xerootg/esp32_zune_bluetooth/pdf/esp32-zune-bluetoothaudio.pdf

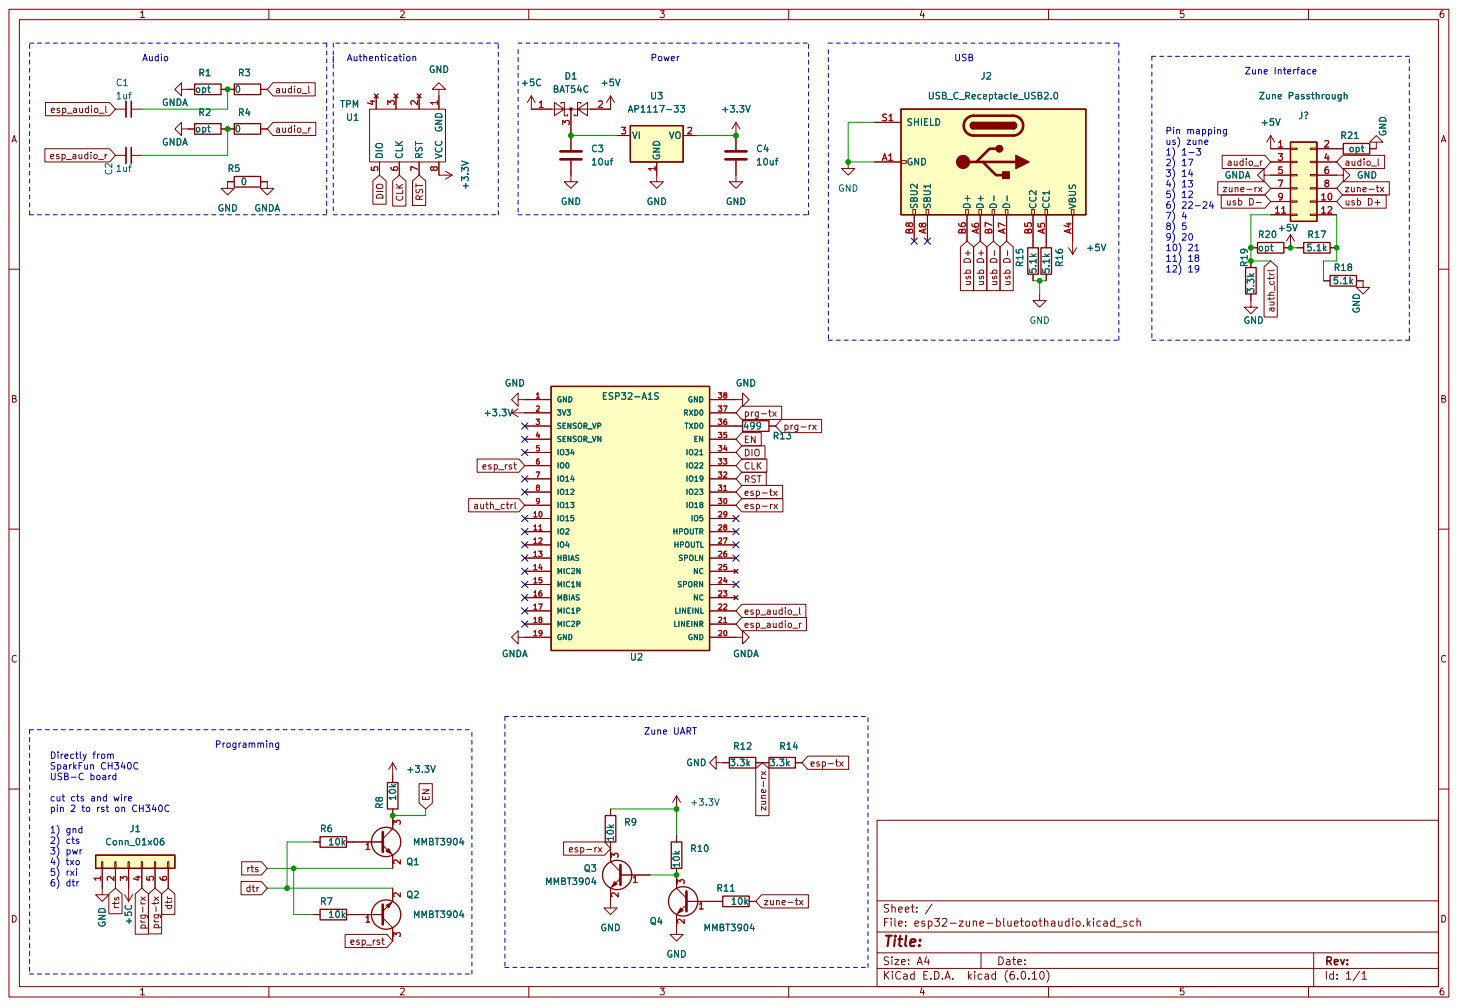
[picture p1: page 1]

1 VO 2 VI 3 GND GND GND

cut cts and wire pin 2 to rst on CH340C

File: esp32-zune-bluetoothaudio.kicad_sch Sheet: /
Id: 1/1 Title:
