xerootg/esp32_zune_bluetooth/esp32-zune-bluetoothaudio.kicad_pcb

## KiCad design esp32-zune-bluetoothaudio.kicad_pcb (2023-01-27)

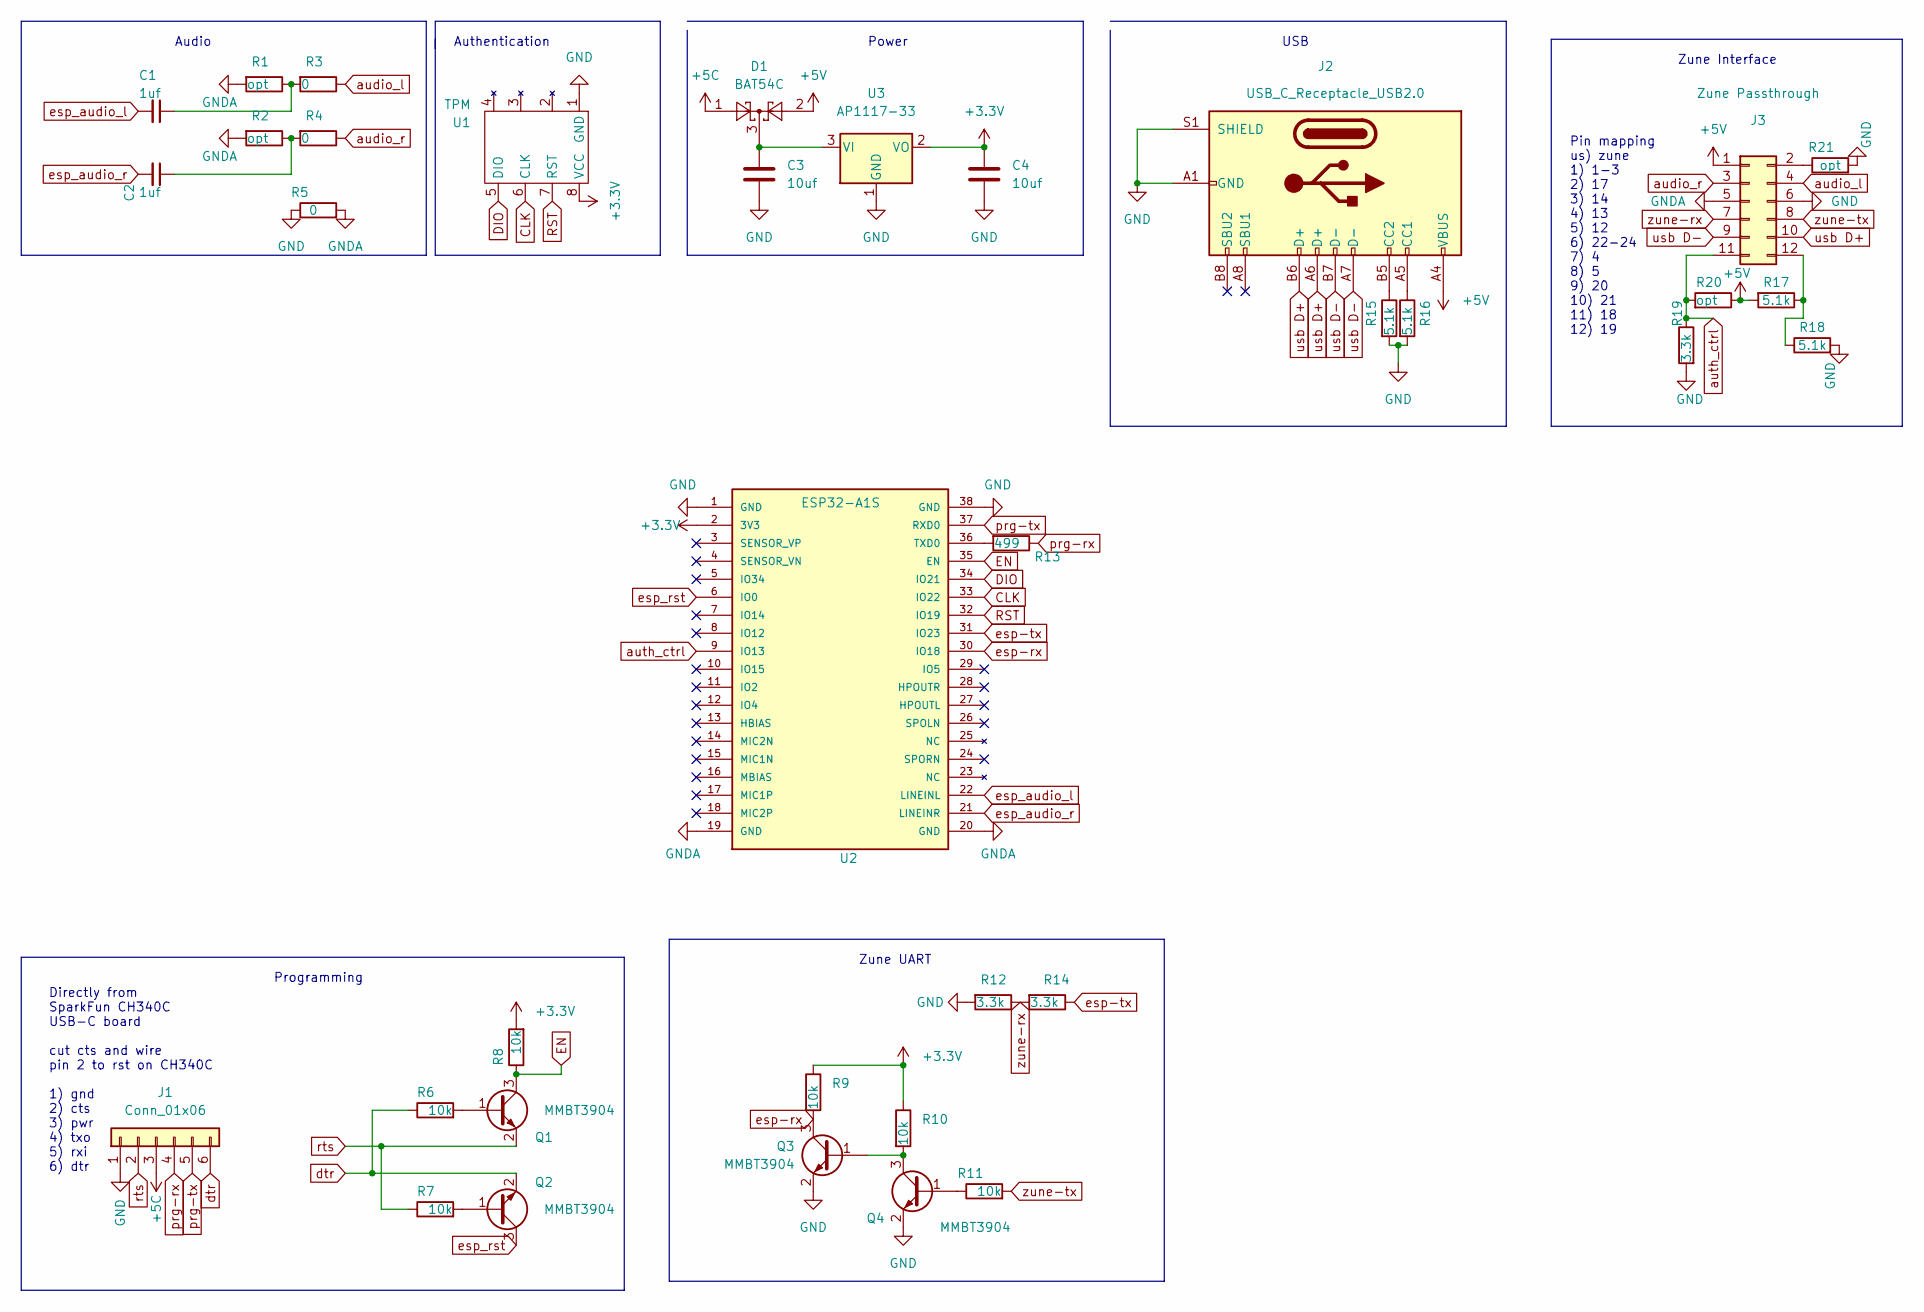
[picture p2: schematic esp32-zune-bluetoothaudio.kicad_sch]

Parts:
C1, C2: 1uf; C_0805_2012Metric_Pad1.18x1.45mm_HandSolder
C3, C4: 10uf; C_0805_2012Metric_Pad1.18x1.45mm_HandSolder
D1: BAT54C; SOT-23
J1: Conn_01x06; PinHeader_1x06_P2.54mm_Vertical
J2: USB_C_Receptacle_USB2.0; USB_C_Receptacle_XKB_U262-16XN-4BVC11
J3: Zune Passthrough; PinHeader_2x06_P2.00mm_Vertical_SMD
Q1, Q2, Q3, Q4: MMBT3904; SOT-23
R1, R2, R20, R21: opt; R_0805_2012Metric_Pad1.20x1.40mm_HandSolder
R3, R4, R5: 0; R_0805_2012Metric_Pad1.20x1.40mm_HandSolder
R6, R7, R8, R9, R10, R11: 10k; R_0805_2012Metric_Pad1.20x1.40mm_HandSolder
R12, R14, R19: 3.3k; R_0805_2012Metric_Pad1.20x1.40mm_HandSolder
R13: 499; R_0805_2012Metric_Pad1.20x1.40mm_HandSolder
R15, R16, R17, R18: 5.1k; R_0805_2012Metric_Pad1.20x1.40mm_HandSolder
U1: TPM; Infineon_PG-DSO-8-27_3.9x4.9mm_EP2.65x3mm
U2: ESP32-A1S; PARTREV 4
U3: AP1117-33; SOT-223-3_TabPin2

Connections:
+3.3V: C4.1, R8.2, R9.1, R10.1, U1.8 (VCC), U2.2 (3V3), U3.2 (VO)
+5C: D1.1, J1.3
+5V: D1.2, J2.A4 (VBUS), J2.A9 (VBUS), J2.B4 (VBUS), J2.B9 (VBUS), J3.1, R17.2, R20.1
CLK: U1.6 (CLK), U2.33 (IO22)
DIO: U1.5 (DIO), U2.34 (IO21)
EN: Q1.3 (C), R8.1, U2.35 (EN)
GND: C3.2, C4.2, J1.1, J2.A1 (GND), J2.A12 (GND), J2.B1 (GND), J2.B12 (GND), J2.S1 (SHIELD), J3.6, Q3.2 (E), Q4.2 (E), R5.1, R12.2, R15.2, R16.2, R18.2, R19.2, R21.2, U1.1 (GND), U2.1 (GND), U2.38 (GND), U3.1 (GND)
GNDA: J3.5, R1.2, R2.2, R5.2, U2.19 (GND), U2.20 (GND)
unnamed: C1.1, R1.1, R3.2
unnamed: C2.1, R2.1, R4.2
unnamed: C3.1, D1.3, U3.3 (VI)
unnamed: J2.A5 (CC1), R16.1
unnamed: J2.B5 (CC2), R15.1
unnamed: Q1.1 (B), R6.2
unnamed: Q2.1 (B), R7.2
unnamed: Q3.1 (B), Q4.3 (C), R10.2
unnamed: Q4.1 (B), R11.1
unnamed: R13.2, U2.36 (TXD0)
unnamed: J3.12, R17.1, R18.1
unnamed: J3.2, R21.1
RST: U1.7 (RST), U2.32 (IO19)
audio_l: J3.4, R3.1
audio_r: J3.3, R4.1
auth_ctrl: J3.11, R19.1, R20.2, U2.9 (IO13)
dtr: J1.6, Q2.2 (E), R6.1
esp-rx: Q3.3 (C), R9.2, U2.30 (IO18)
esp-tx: R14.1, U2.31 (IO23)
esp_audio_l: C1.2, U2.22 (LINEINL)
esp_audio_r: C2.2, U2.21 (LINEINR)
esp_rst: Q2.3 (C), U2.6 (IO0)
prg-rx: J1.4, R13.1
prg-tx: J1.5, U2.37 (RXD0)
rts: J1.2, Q1.2 (E), R7.1
usb D+: J2.A6 (D+), J2.B6 (D+), J3.10
usb D-: J2.A7 (D-), J2.B7 (D-), J3.9
zune-rx: J3.7, R12.1, R14.2
zune-tx: J3.8, R11.2

Notes on the sheet:
Zune Interface
Pin mapping us) zune 1) 1-3 2) 17 3) 14 4) 13 5) 12 6) 22-24 7) 4 8) 5 9) 20 10) 21 11) 18 12) 19
Zune UART
Authentication
USB
Audio
Programming
Power
Directly from SparkFun CH340C USB-C board cut cts and wire pin 2 to rst on CH340C 1) gnd 2) cts 3) pwr 4) txo 5) rxi 6) dtr

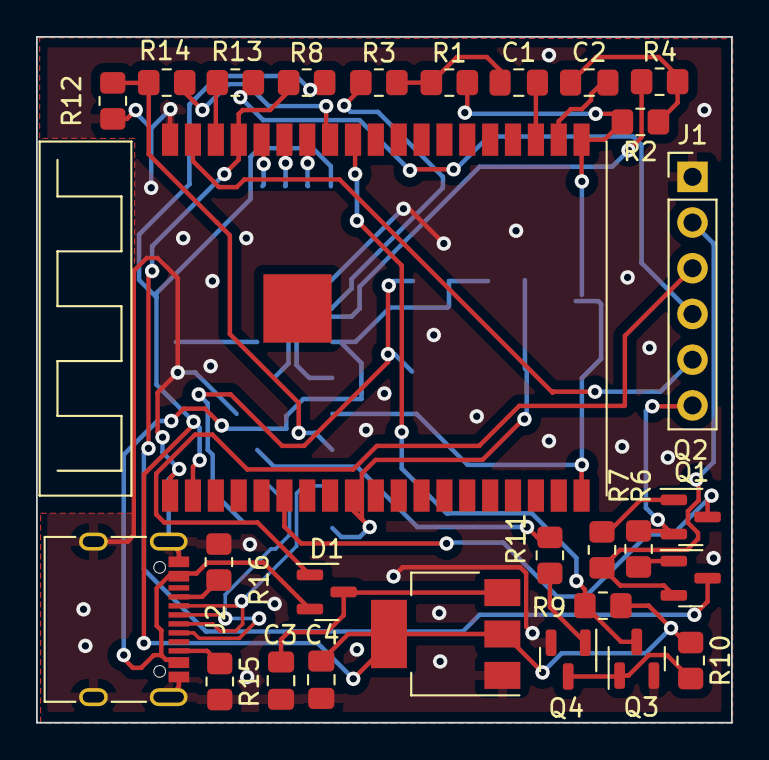
[picture p3: board esp32-zune-bluetoothaudio.kicad_pcb from above]

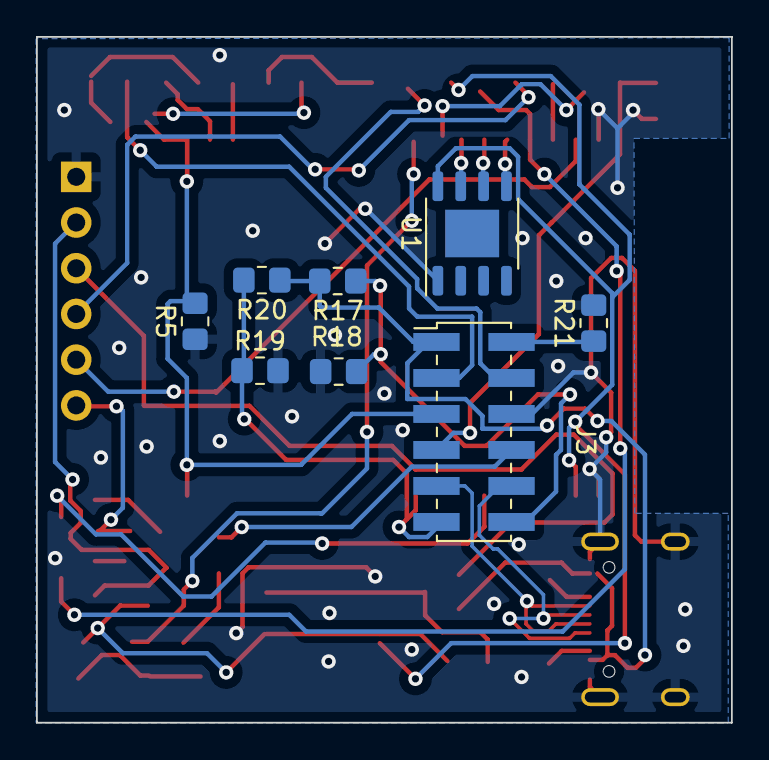
[picture p4: board esp32-zune-bluetoothaudio.kicad_pcb from below]

Board: 2 copper layers, 38.6 x 38.1 mm, 36 parts (8 on the bottom side), 37 nets.
