xerootg/esp32_zune_bluetooth/(commit log)

2023-01-10 Got a start atleast
    [esp32-zune-bluetoothaudio.kicad_pcb, esp32-zune-bluetoothaudio.kicad_sch]
2023-01-21 cleanup a bit, add level shifting
    [esp32-zune-bluetoothaudio.kicad_sch]
2023-01-23 Needs gain adjustment, uart commands, uart actually hooked up... but we have audio. on a dev board anyway.
2023-01-23 update to represent the state of the breadboard
    [esp32-zune-bluetoothaudio.kicad_sch]
2023-01-25 starting to write a zune "driver", updating schematic to match breadboard. I'm getting close to laying out a pcb.
    [esp32-zune-bluetoothaudio.kicad_sch]
2023-01-27 Symbols mostly associated, almost ready for PCB
    [esp32-zune-bluetoothaudio.kicad_sch]
2023-01-27 well... its a pcb without routing and its too big. gonna try to make it a two board layout, placing the esp32 behind the body of the zune.
    [esp32-zune-bluetoothaudio.kicad_pcb, esp32-zune-bluetoothaudio.kicad_sch]
2023-01-27 well, this is what I submitted for fabrication validation
    [esp32-zune-bluetoothaudio.kicad_pcb]
2023-01-31 Currently, the xbox chip is not working. I am working on that, but in the meantime, here's significant cleanup.
    [ZuneBT.cpp, a2dp.cpp, xbox_driver.cpp, zune_driver.cpp, zune_driver.h]
2023-01-31 make the xbox driver return length
2023-01-31 this seems to abort before it's supposed to. im gonna backport the "old" driver to the new header, but this is here for if i need it.
